DIYPLC/DIY_PLC/src/DIY_PLC_V3.1/TEST HW.jpg

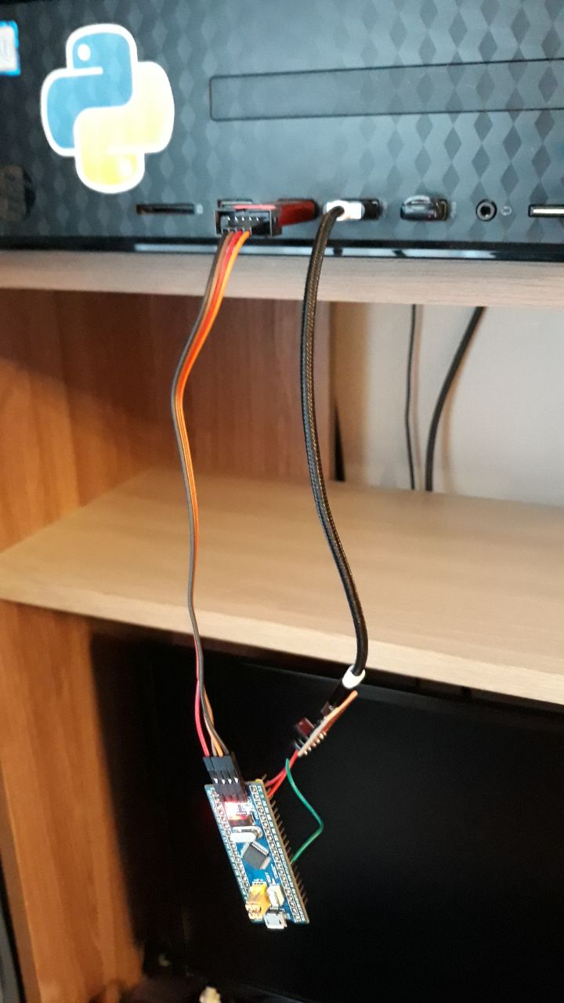
src/DIY_PLC_V3.1/TEST HW.jpg
