DIYPLC/DIY_PLC/Box/photo.jpg

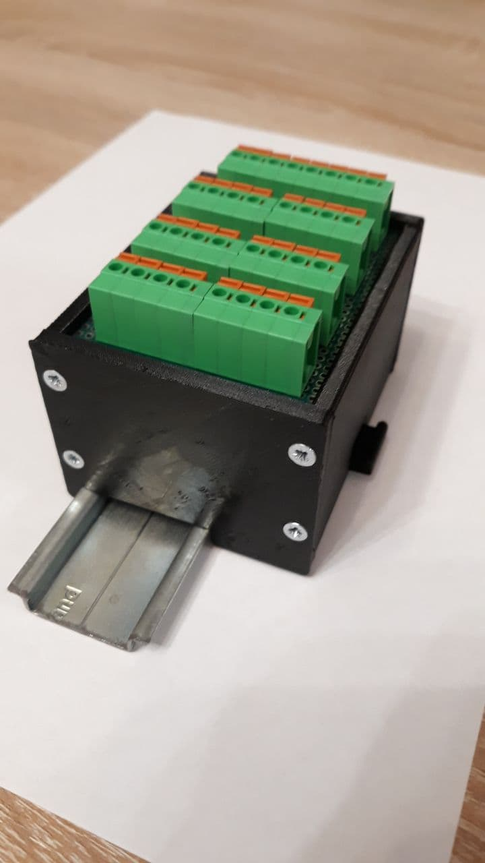
Box/photo.jpg
