DIYPLC/DIY_PLC/PCB/Digital input/PCB_PCB_DI_TLP2362_24V_3V3_2022-10-15.pdf

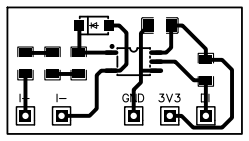
[picture p3: figure]
