DIYPLC/DIY_PLC/PCB/Digital output/PCB_PCB_DO_PVG612SPBF_24V_3V3_2022-10-15.pdf

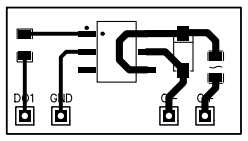
[picture p4: figure]
