DIYPLC/DIY_PLC/PCB/3D.png

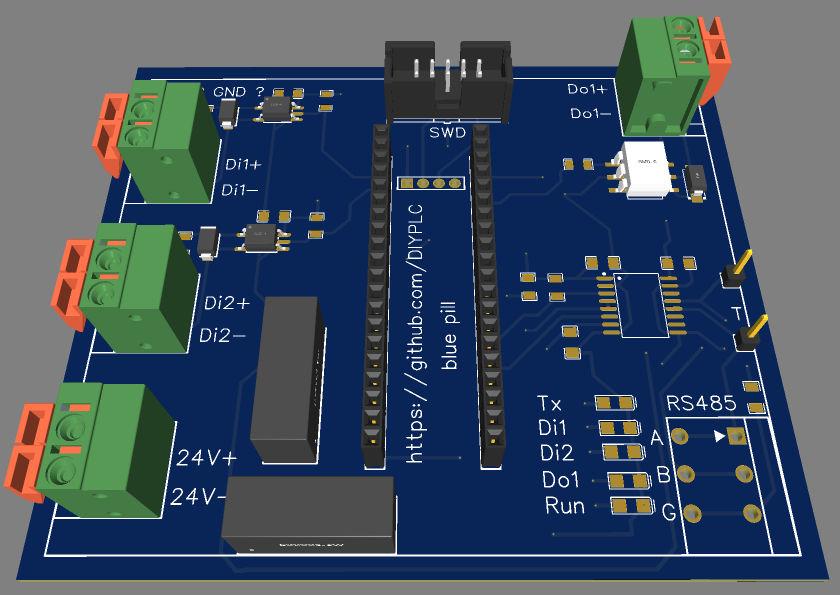
PCB/3D.png
