DIYPLC/DIY_PLC/PCB/BOM_DIY_PLC_V3_2022-04-12.csv

ID | Name | Designator | Footprint | Quantity | Manufacturer Part | Manufacturer | Supplier | Supplier Part | Price | Pins | JLCPCB Part Class | Contributor | JLCPCB Part Class | Resistance (Ohms) | link
1 | 100nF | C1,C2,C3,C5,C7,C8,C9,C10 | C1206 | 8 | GRM31C5C1H104JA01L | MuRata | LCSC | C97946 | 0.138 | 2 | Extended Part
2 | 47uF | C4,C6 | CAP-SMD_L3.5-W2.8-R-RD | 2 | TPSB476K006R0250 | AVX | LCSC | C444791 | 0.387 | 2 | Extended Part | LCSC
3 | 5103308-1 | CN1 | IDC-TH_5103308-1 | 1 | 5103308-1 | TE Connectivity | LCSC | C86466 | 1.323 | 10 | Extended Part
4 | KF142V-5.08-2P | CN2,CN3,CN4,CN5 | CONN-TH_P5.08_KF142V-5.08-2P | 4 | KF142V-5.08-2P | Cixi Kefa Elec | LCSC | C475134 | 0.209 | 2 | Extended Part | LCSC
5 | KF142V-5.08-3P | CN6 | CONN-TH_3P-P5.08_KF142V-5.08-3P | 1 | KF142V-5.08-3P | Cixi Kefa Elec | LCSC | C475135 | 0.268 | 3 | Extended Part | LCSC
6 | US1M_C181135 | D1,D2 | DO-214AC_L4.3-W2.7-LS5.3-FD | 2 | US1M | Hottech | LCSC | C181135 | 0.01 | 2 | Extended Part | 立创EDA官方封装库 | Extended Part
7 | M7 | D3,D4 | SMA_L4.4-W2.8-LS5.4-RD | 2 | M7 | Bourne Semicon (Shenzhen) | LCSC | C266550 | 0.013 | 2 | Extended Part | LCSC
8 | SMBJ28CA-TR | D5 | SMB_L4.6-W3.6-LS5.3-BI | 1 | SMBJ28CA-TR | STMicroelectronics | LCSC | C133664 | 0.13 | 2 | Extended Part | LCSC
9 | 0437.500WR | F1,F2 | F1206 | 2 | 0437.500WR | Littelfuse | LCSC | C206953 | 0.334 | 2 | Extended Part | LCSC
10 | A2541HWV-4P | H1 | HDR-TH_4P-P2.54-V_A2541HWV-4P | 1 | A2541HWV-4P | Changjiang Connectors | LCSC | C225501 | 0.091 | 4 | Extended Part | LCSC
11 | MHT150CYCT | LED1,LED2,LED3,LED4,LED5 | LED1206-RD_YELLOW-1 | 5 | MHT150CYCT | MEIHUA | LCSC | C409783 | 0.06 | 2 | Extended Part | LCSC
12 | Header-Female-2.54_1x20 | P1,P2 | HDR-TH_20P-P2.54-V-F | 2 | 2.54mm 1*20P Female header | BOOMELE | LCSC | C50984 | 0.151 | 20 | Extended Part
13 | 4.7kΩ | R1,R2,R3,R4,R22 | R1206 | 5 | 1206W4F4701T5E | UniOhm | LCSC | C17936 | 0.004 | 2 | Basic Part |  |  | 4.7K
14 | 430Ω | R5,R9 | R1206 | 2 | 1206W4F4300T5E | UniOhm | LCSC | C17965 | 0.004 | 2 | Extended Part |  |  | 430
15 | 1K | R6,R7,R8,R10,R11,R12 | R1206 | 6 | AECR1206F1K00K9 | ResistorToday | LCSC | C328410 | 0.007 | 2 |  | LCSC
16 | 330Ω | R13 | R1206 | 1 | NQ06W4F3300T5E | UNI-ROYAL(Uniroyal Elec) | LCSC | C965041 | 0.009 | 2 | Extended Part | LCSC
17 | 0Ω | R14,R15,R16,R17,R18,R19,R23 | R1206 | 7 | 1206W4F0000T5E | UniOhm | LCSC | C17888 | 0.004 | 2 | Basic Part |  |  | 0
18 | 10kΩ | R20,R21 | R1206 | 2 | 1206W4F1002T5E | UniOhm | LCSC | C17902 | 0.004 | 2 | Basic Part |  |  | 10K
19 | KH-PG2012005-DZ | TP1 | TESTPOINT-TH_KH-PG2012005-DZ | 1 | KH-PG2012005-DZ | kinghelm(金航标) | LCSC | C2842936 | 0.209 | 1 | Extended Part | LCSC
20 | HDR-M-2.54_1x1 | TP2,TP3 | HDR-M-2.54_1X1 | 2 |  |  | LCSC | C81276 | 0.007 | 1 |  | LCEDA_Lib
21 | TLP2362(TPL,E(T | U1,U2 | OPTO-SMD-5_L3.7-W4.6-P1.27-LS7.0-BR | 2 | TLP2362(TPL,E(T | TOSHIBA | LCSC | C37658 | 1.634 | 5 | Extended Part
22 | PVG612SPBF | U1_DO | SMD-6_L8.6-W6.4-P2.54-LS9.4-BL | 1 | PVG612SPBF | Infineon Technologies | LCSC | C538601 | 10.062 | 6 | Extended Part | LCSC
23 | B2405S-2W | U3,U4 | PWRM-TH_BXXXXS-2W | 2 | B2405S-2W | JETEKPS | LCSC | C442554 | 3.625 | 4 | Extended Part | LCSC
24 | AMS1117-3.3S | U5 | SOT-223-4_L6.5-W3.5-P2.30-LS7.0-BL | 1 | AMS1117-3.3S | KEXIN(科信) | LCSC | C2842296 | 0.091 | 4 |  | LCSC |  |  | https://atta.szlcsc.com//upload/public/pdf/source/20220119/687E7B65F4F54F278E2F75AE3BEEDBF9.pdf
25 | ADM2486BRWZ | U6 | SOIC-16_L10.3-W7.5-P1.27-LS10.3-BL | 1 | ADM2486BRWZ | ADI(亚德诺)/LINEAR | LCSC | C658083 | 3.325 | 16 | Extended Part | LCSC
