DIYPLC/DIY_PLC/PCB/Digital input/BOM_DI_TLP2362_24V_3V3_2022-10-15.csv

ID | Name | Designator | Footprint | Quantity | Manufacturer Part | Manufacturer | Supplier | Supplier Part | Price | Pins | JLCPCB Part Class | Contributor | JLCPCB Part Class | Resistance (Ohms)
1 | HDR-M-2.54_1x1 | 3V3,DI,GND,I+,I- | HDR-M-2.54_1X1 | 5 |  |  | LCSC | C81276 | 0.007 | 1 |  | LCEDA_Lib
2 | 100nF | C1 | C1206 | 1 | GRM31C5C1H104JA01L | MuRata | LCSC | C97946 | 0.117 | 2 | Extended Part
3 | US1M_C181135 | D1 | DO-214AC_L4.3-W2.7-LS5.3-FD | 1 | US1M | Hottech | LCSC | C181135 | 0.009 | 2 | Extended Part | 立创EDA官方封装库 | Extended Part
4 | 430Ω | R1 | R1206 | 1 | 1206W4F4300T5E | UniOhm | LCSC | C17965 | 0.003 | 2 | Extended Part |  |  | 430
5 | 1K | R2,R3,R4 | R1206 | 3 | AECR1206F1K00K9 | ResistorToday | LCSC | C328410 | 0.012 | 2 |  | LCSC
6 | TLP2362(TPL,E(T | U1 | OPTO-SMD-5_L3.7-W4.6-P1.27-LS7.0-BR | 1 | TLP2362(TPL,E(T | TOSHIBA | LCSC | C37658 | 0.661 | 5 | Extended Part
