DIYPLC/DIY_PLC/PCB/Digital output/BOM_DO_PVG612SPBF_24V_3V3_2022-10-15.csv

ID | Name | Designator | Footprint | Quantity | Manufacturer Part | Manufacturer | Supplier | Supplier Part | Price | Pins | JLCPCB Part Class | Contributor
1 | M7 | D3 | SMA_L4.4-W2.8-LS5.4-RD | 1 | M7 | Bourne Semicon (Shenzhen) | LCSC | C266550 | 0.012 | 2 | Extended Part | LCSC
2 | HDR-M-2.54_1x1 | DO1,GND,O+,O- | HDR-M-2.54_1X1 | 4 |  |  | LCSC | C81276 | 0.007 | 1 |  | LCEDA_Lib
3 | 0437.500WR | F1 | F1206 | 1 | 0437.500WR | Littelfuse | LCSC | C206953 | 0.296 | 2 | Extended Part | LCSC
4 | 330Ω | R13 | R1206 | 1 | NQ06W4F3300T5E | UNI-ROYAL(Uniroyal Elec) | LCSC | C965041 | 0.011 | 2 | Extended Part | LCSC
5 | PVG612SPBF | U1_DO | SMD-6_L8.6-W6.4-P2.54-LS9.4-BL | 1 | PVG612SPBF | Infineon Technologies | LCSC | C538601 | 3.641 | 6 | Extended Part | LCSC
