DIYPLC/DIY_PLC/Box/Корпус DIN v7 PCB120x80.stl

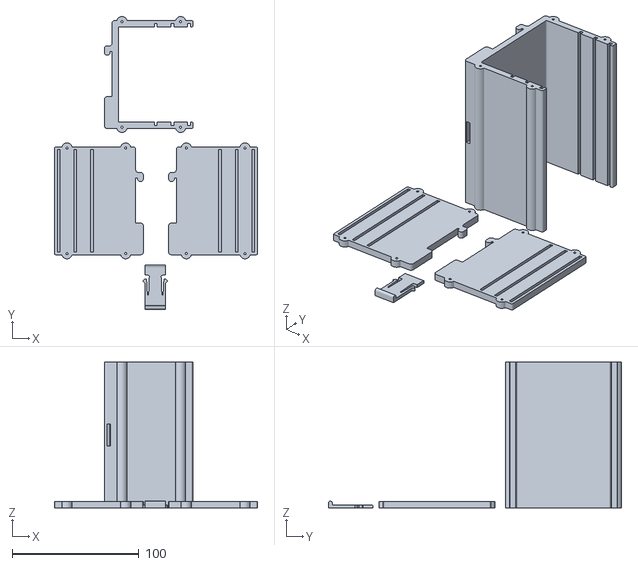
[picture p6: CAD file, 2022-10-21]
Box/Корпус DIN v7 PCB120x80.stl
160.0 x 230.9 x 115.0
