DIYPLC/DIY_PLC/PCB/Digital input/PCB_DI_TLP2362_24V_3V3_2022-10-15.dxf

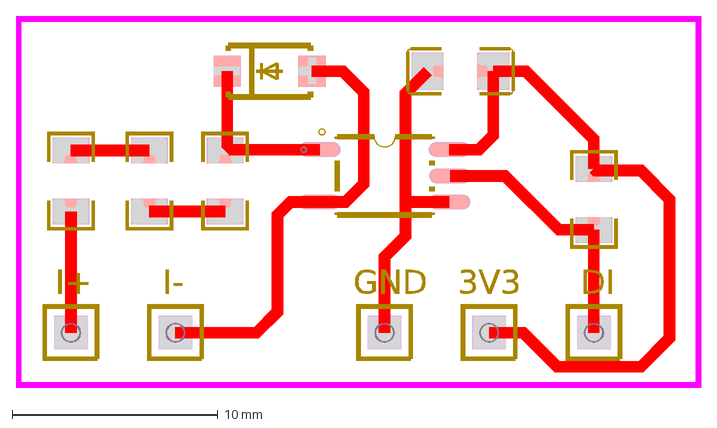
[picture p7: CAD file, 2022-10-15]
PCB/Digital input/PCB_DI_TLP2362_24V_3V3_2022-10-15.dxf
3V3
GND
DI
I+
I-
