DIYPLC/DIY_PLC/PCB/Digital output/PCB_DO_PVG612SPBF_24V_3V3_2022-10-15.dxf

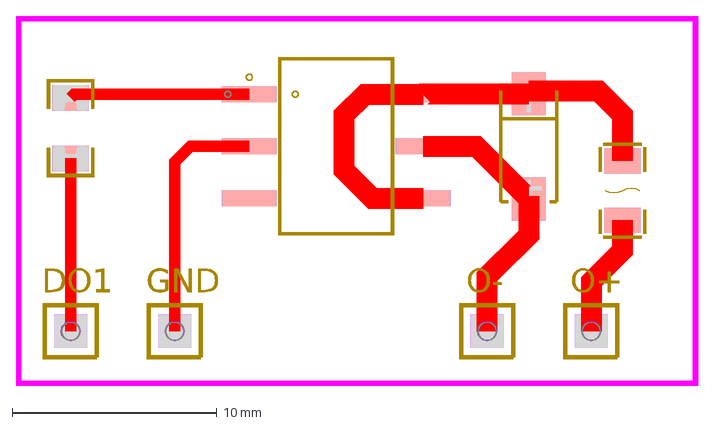
[picture p8: CAD file, 2022-10-15]
PCB/Digital output/PCB_DO_PVG612SPBF_24V_3V3_2022-10-15.dxf
DO1
GND
O+
O-
