DIYPLC/DIY_PLC/PCB/RS485/PCB_RS485_ADM2486BRWZ_2022-10-15.dxf

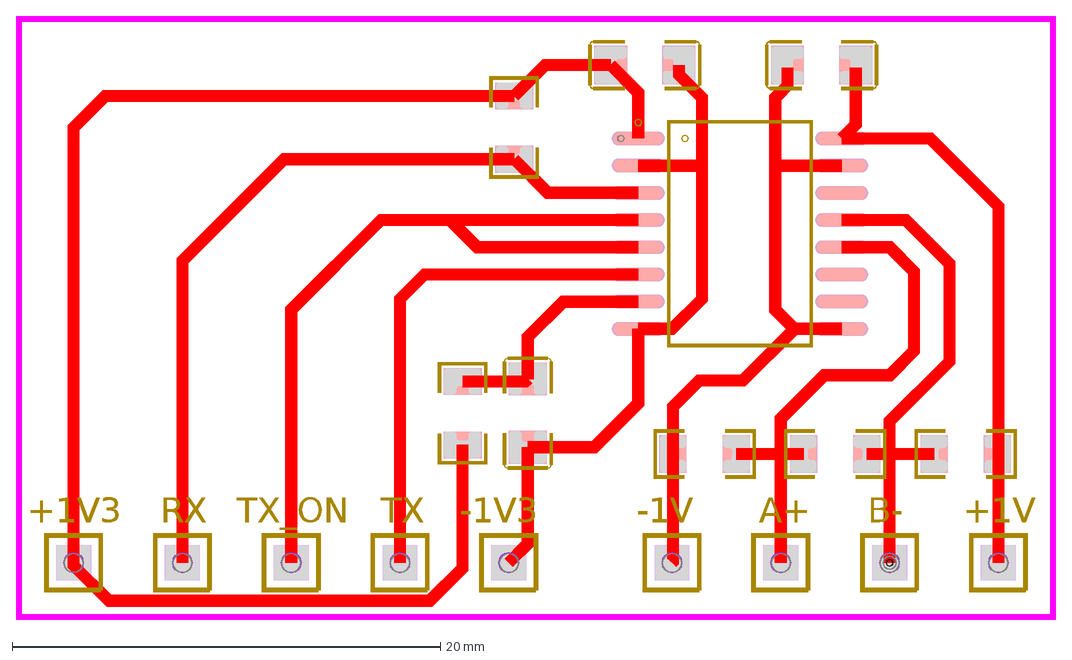
[picture p9: CAD file, 2022-10-15]
PCB/RS485/PCB_RS485_ADM2486BRWZ_2022-10-15.dxf
A+
B-
RX
TX
TX_ON
+1V
+1V3
-1V
-1V3
