DIYPLC/DIY_PLC/Box/Архив/Корпус DIN v6 PCB 100x85.FCStd

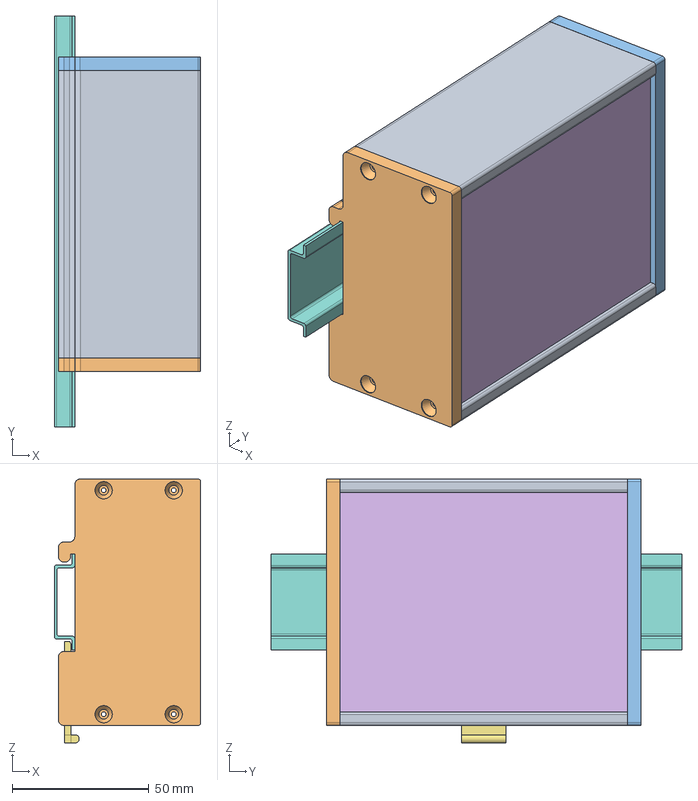
[picture p10: CAD file, 2022-10-21]
Box/Архив/Корпус DIN v6 PCB 100x85.FCStd
53.5 x 150.0 x 96.4 mm
корпус
крышка Левая
крышка правая
плата 1
плата2
плата 3
защёлка
DIN-рейка
