DIYPLC/DIY_PLC/(list of files, cad)

Other CAD files:
Box/Архив/Корпус DIN v5 PCB 80x60.dxf
Box/Архив/Корпус DIN v6 PCB 100x85.dxf
Box/Корпус DIN v7 PCB120x80.dxf
