DIYPLC/DIY_PLC/PCB/Schematic_DIY_PLC_V3_2022-04-12.pdf

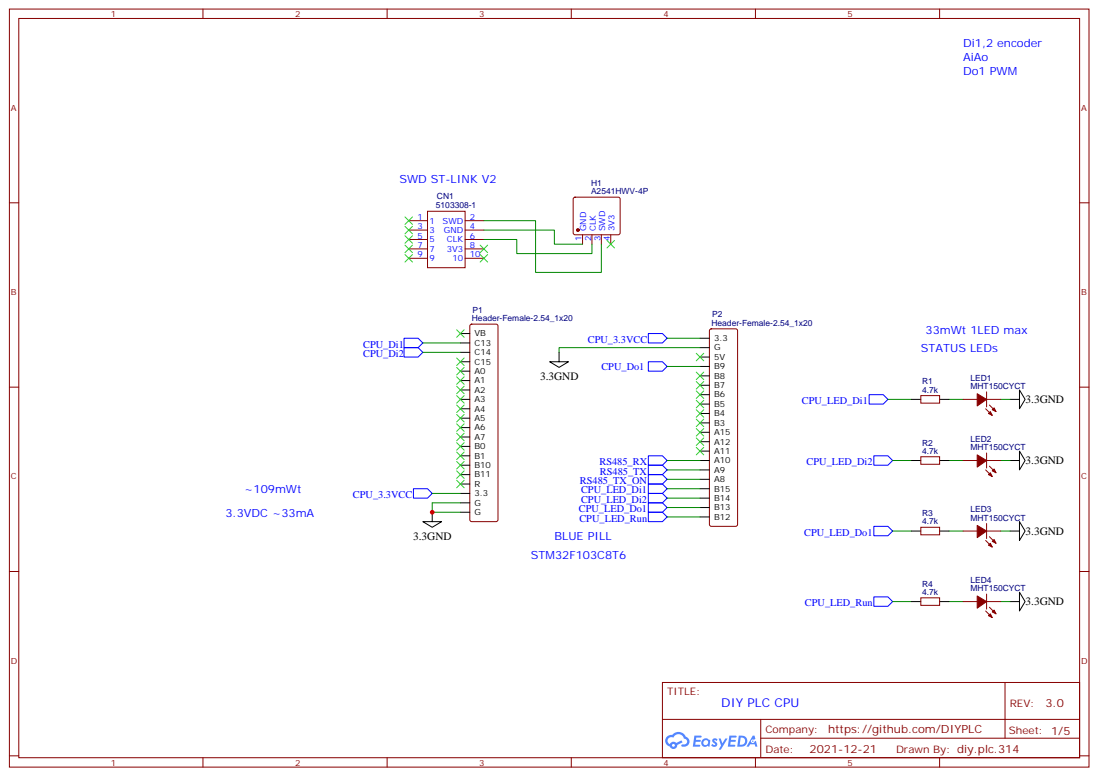
[picture p11: page 1]

Company: https://github.com/DIYPLC

Drawn By: diy.plc.314

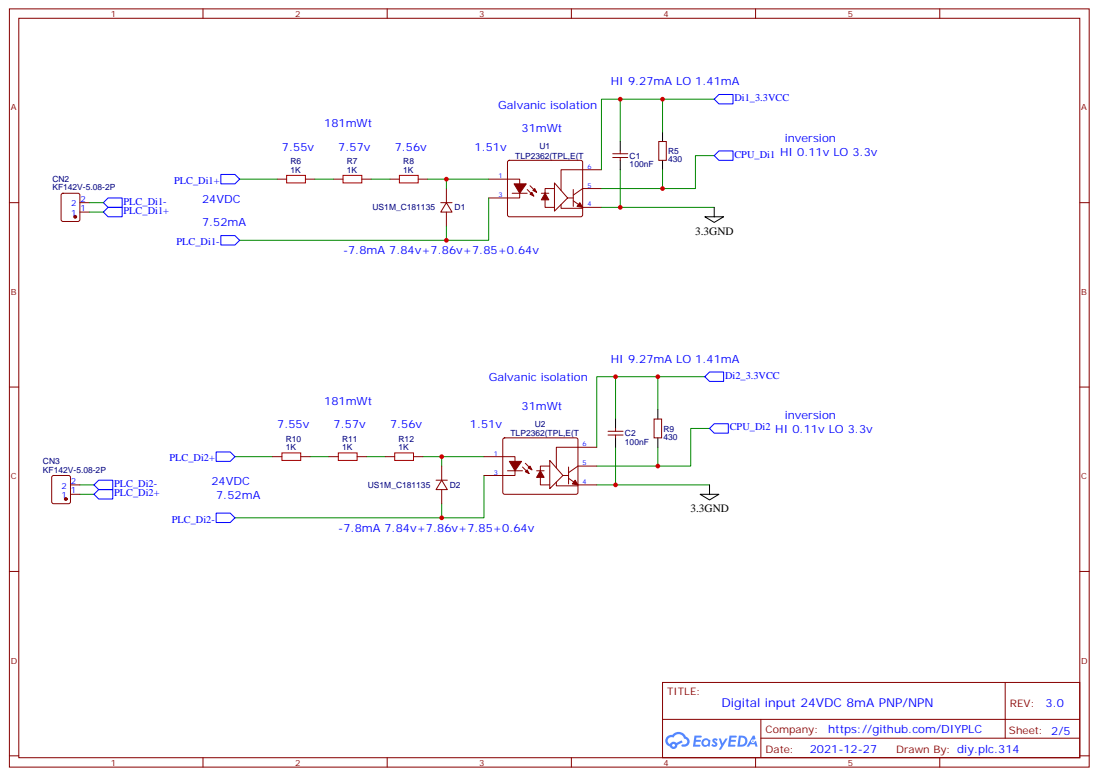
[picture p12: page 2]

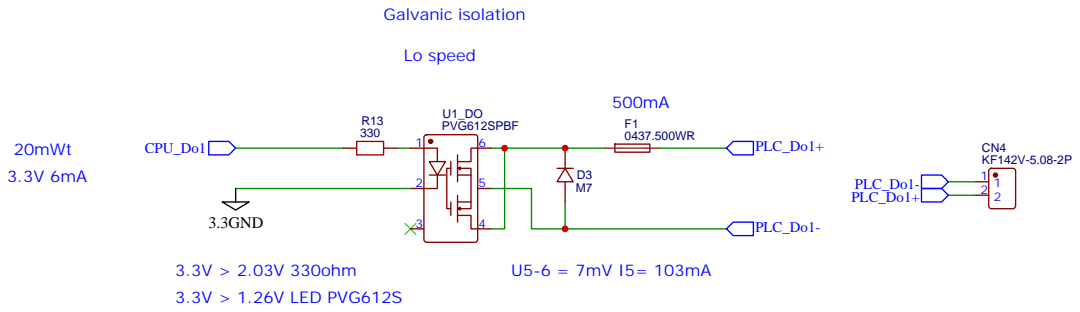
[picture p13: page 3]

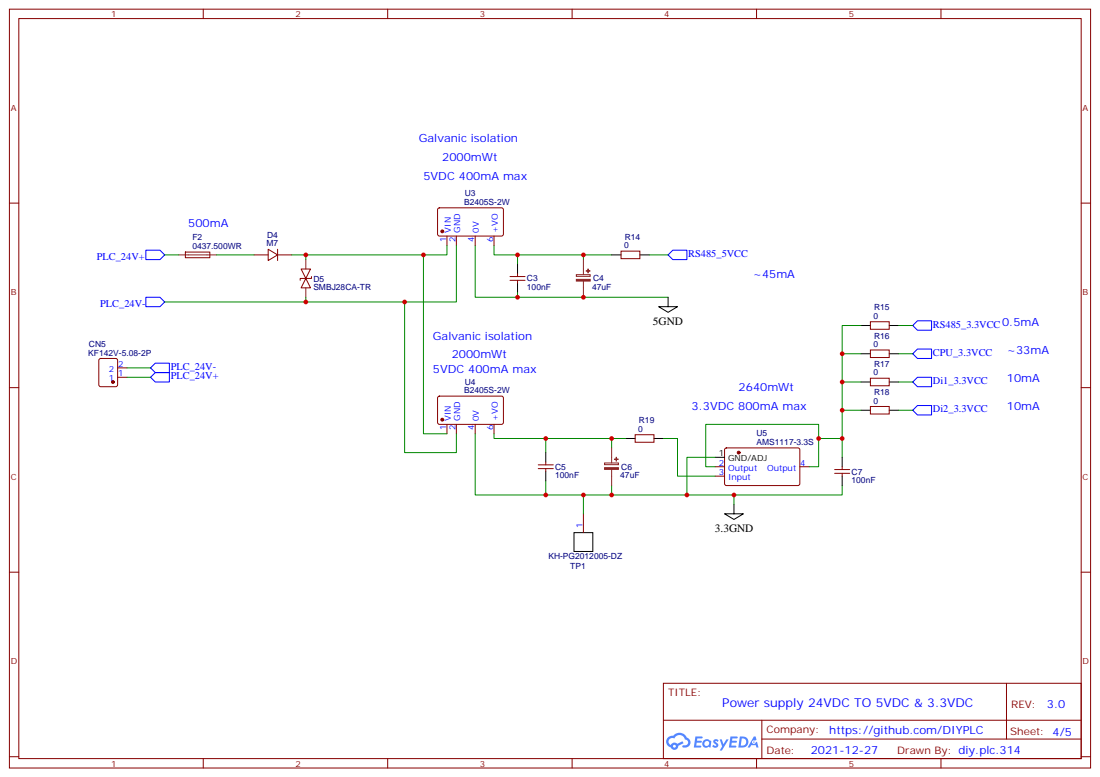
[picture p14: page 4]

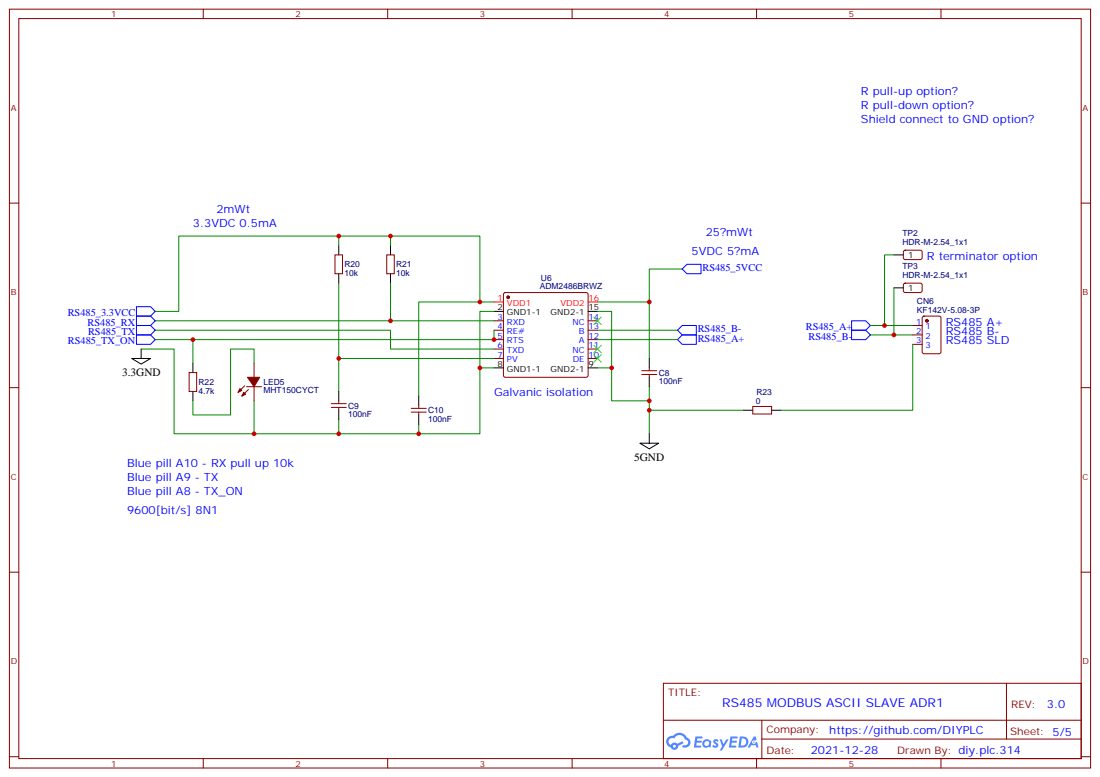
[picture p15: page 5]

R pull-up option?
R pull-down option?
Shield connect to GND option?

Blue pill A10 - RX pull up 10k
Blue pill A9 - TX
Blue pill A8 - TX_ON
9600[bit/s] 8N1
