DIYPLC/DIY_PLC/Box/Защелка v7 PCB120x80-А4.pdf

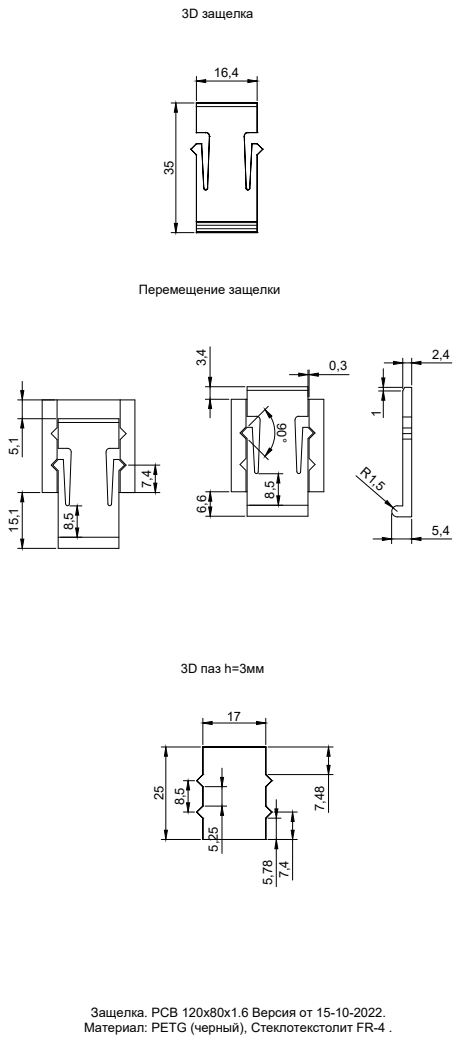
[picture p16: page 1]
3D защелка 3,4 6,6; Перемещение защелки; 3D паз h=3мм

Защелка. PCB 120x80x1.6 Версия от 15-10-2022.
Материал: PETG (черный), Стеклотекстолит FR-4 .
