DIYPLC/DIY_PLC/Box/Корпус DIN v7 PCB120x80-А4.pdf

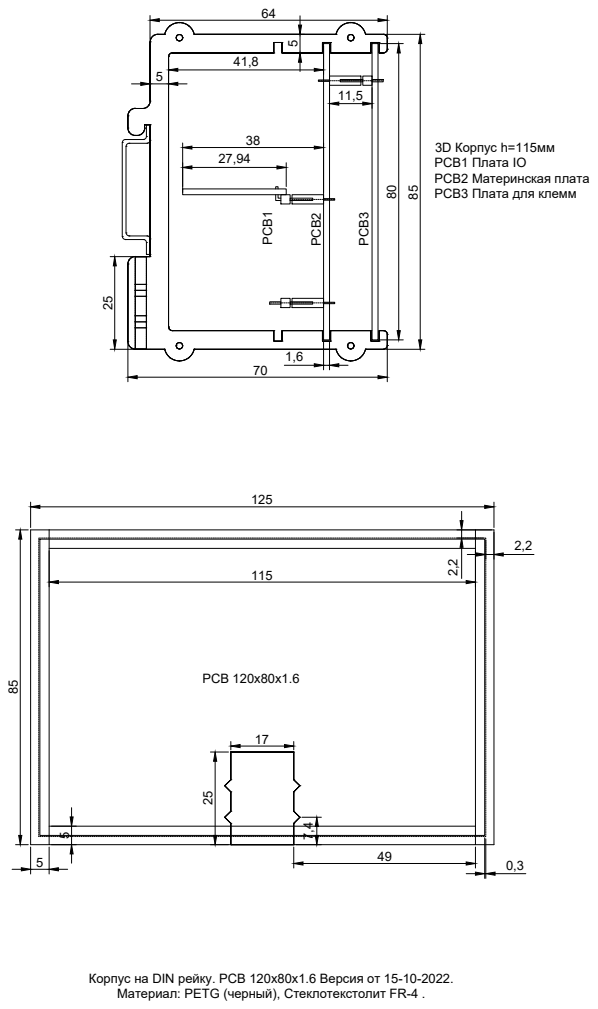
[picture p17: page 1]
11,5 PCB1; PCB2; PCB3; PCB 120x80x1.6

3D Корпус h=115мм
PCB1 Плата IO
PCB2 Материнская плата
PCB3 Плата для клемм

Корпус на DIN рейку. PCB 120x80x1.6 Версия от 15-10-2022.
Материал: PETG (черный), Стеклотекстолит FR-4 .
