DIYPLC/DIY_PLC/Box/Крышки v7 PCB120x80-А4.pdf

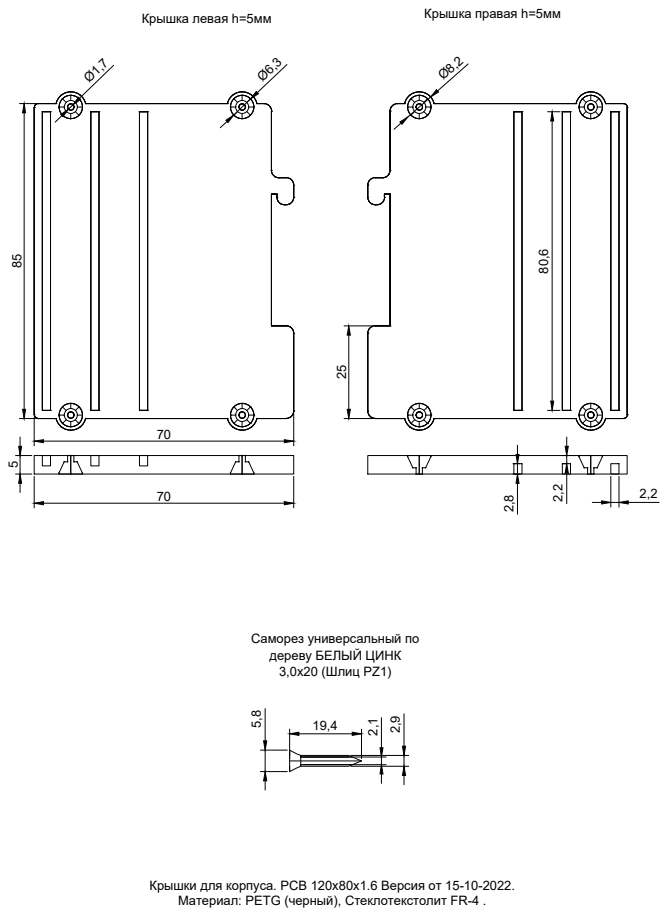
[picture p18: page 1]
Крышка левая h=5мм; Крышка правая h=5мм

Саморез универсальный по
дереву БЕЛЫЙ ЦИНК
3,0х20 (Шлиц PZ1)

Материал: PETG (черный), Стеклотекстолит FR-4 . 5,8

Крышки для корпуса. PCB 120x80x1.6 Версия от 15-10-2022.
