DIYPLC/DIY_PLC/PCB/Digital input/Schematic_DI_TLP2362_24V_3V3_2022-10-15.pdf

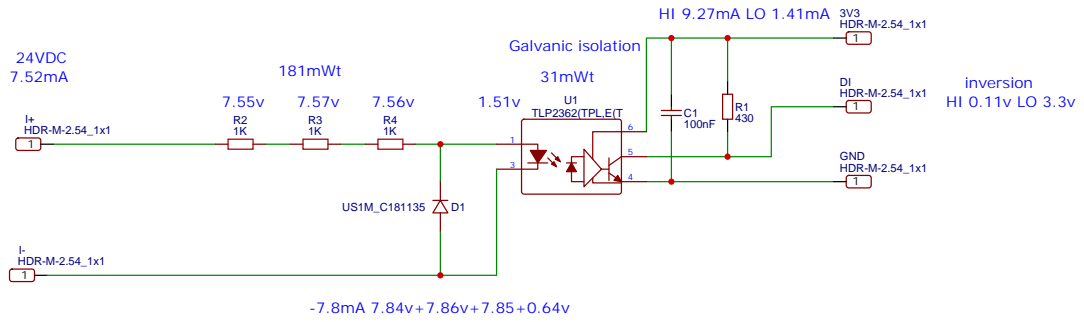
[picture p19: page 1]

Company: https://github.com/DIYPLC

Drawn By: diy.plc.314
