DIYPLC/DIY_PLC/PCB/Digital output/Schematic_DO_PVG612SPBF_24V_3V3_2022-10-15.pdf

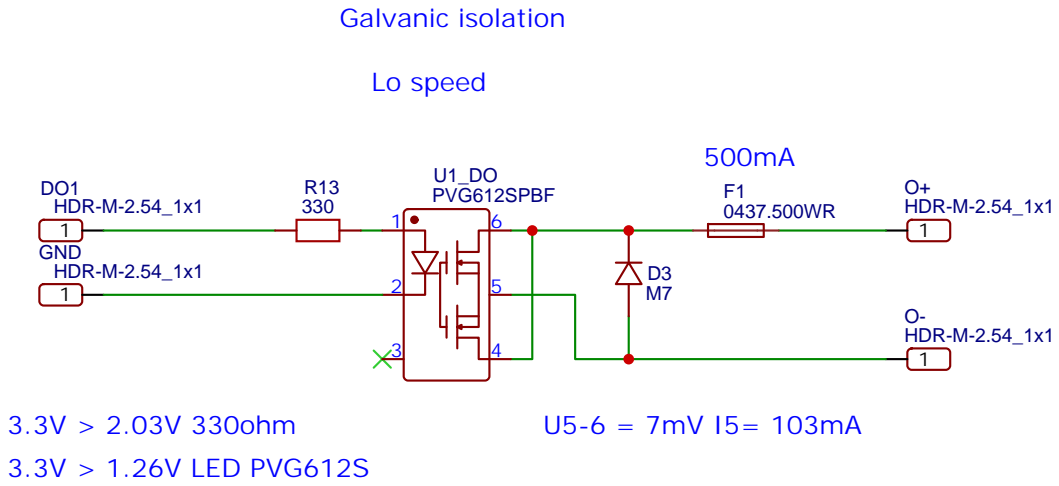
[picture p20: page 1]

Company: https://github.com/DIYPLC

Drawn By: diy.plc.314
