DIYPLC/DIY_PLC/PCB/RS485/Schematic_RS485_ADM2486BRWZ_2022-10-15.pdf

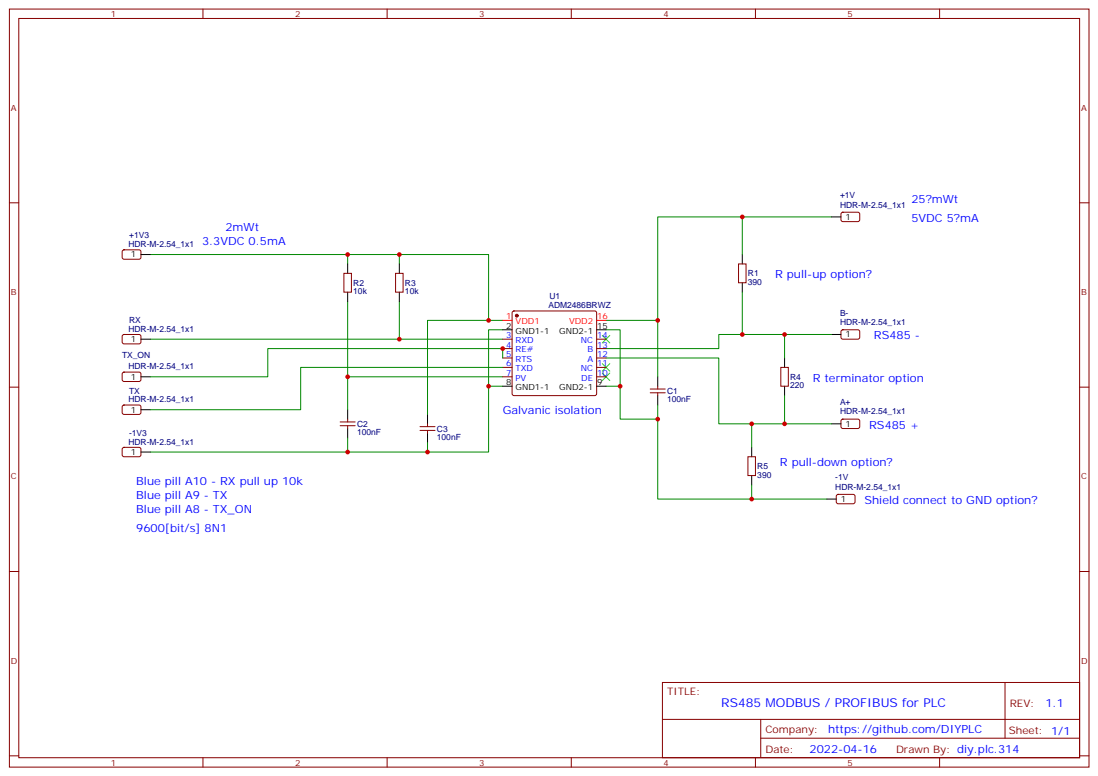
[picture p21: page 1]
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

Company: https://github.com/DIYPLC

Drawn By: diy.plc.314
