DIYPLC/DIY_PLC/PCB/PCB_PCB_DIY_PLC_V3_2022-04-12.pdf

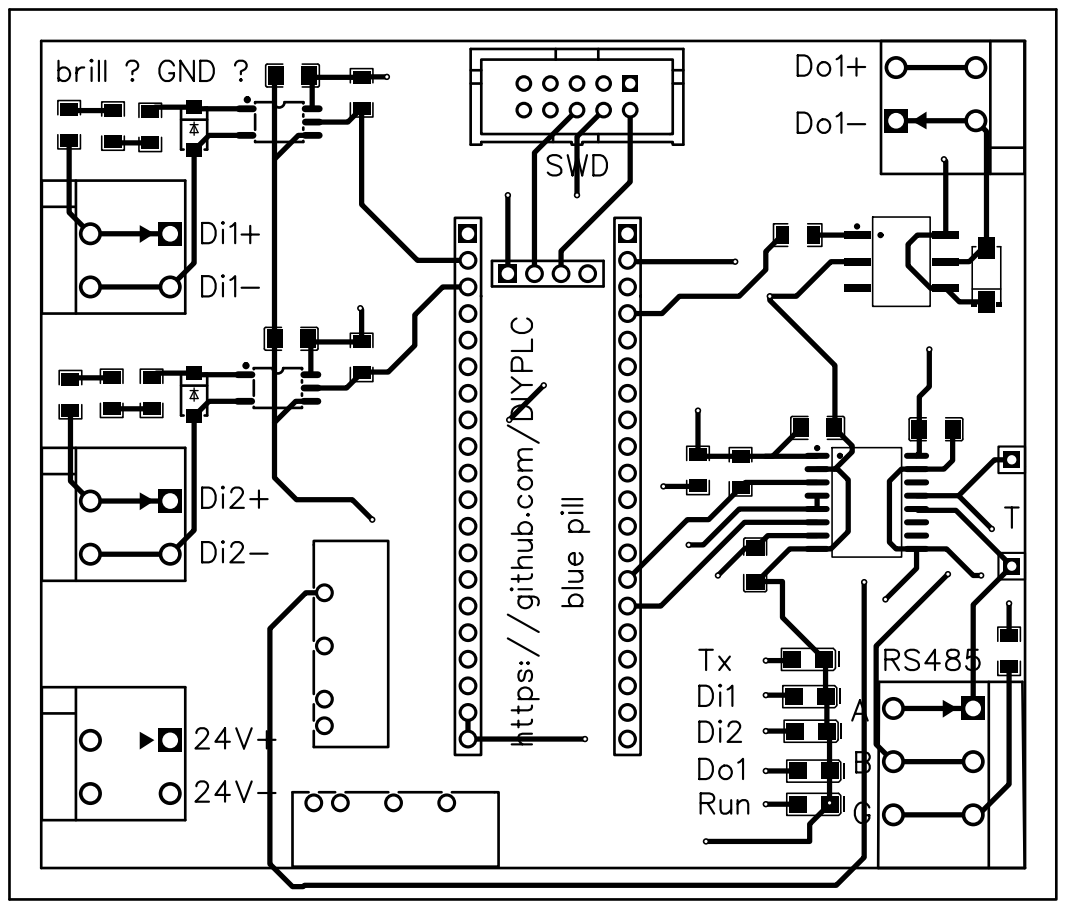
[picture p22: page 1]
