DIYPLC/DIY_PLC/PCB/RS485/PCB_PCB_RS485_ADM2486BRWZ_2022-10-15.pdf

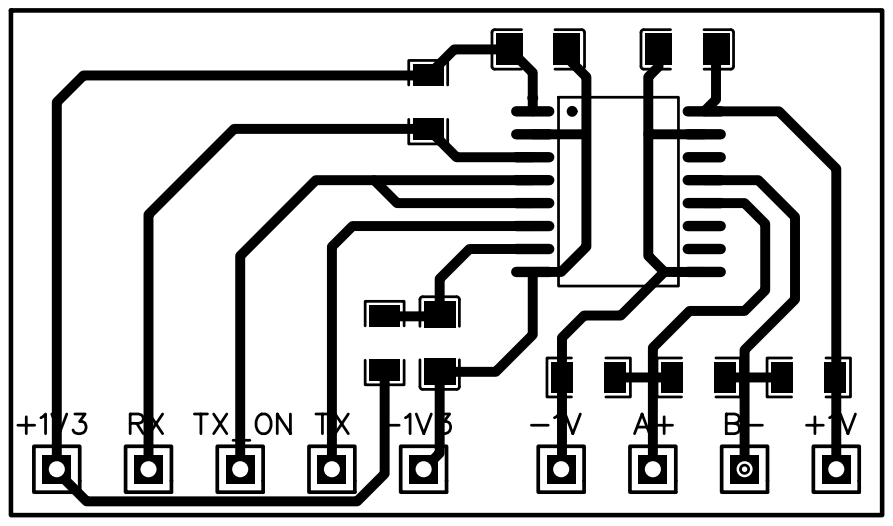
[picture p23: page 1]
