DIYPLC/DIY_PLC/src/DIY_PLC_V3.1/main.c

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
/* Includes ------------------------------------------------------------------*/
#include "main.h"

/* USER CODE BEGIN Includes */
#include <stdint.h>
#include <stdbool.h>
#include <iso646.h>

#include "mb.h" //MODBUS RTU SLAVE
#include "GlobalVar.h"
#include "FbTs.h"
#include "FbBlink.h"
#include "FbFilterA.h"
/* USER CODE END Includes */

/* USER CODE BEGIN PD */
#define SetBit(Var,Bit)   ( Var = Var |  (1 << (Bit)) )
#define ResetBit(Var,Bit) ( Var = Var & ~(1 << (Bit)) )

#define USER_LED_ON() HAL_GPIO_WritePin(GPIOC, GPIO_PIN_13, GPIO_PIN_RESET)
#define USER_LED_OFF() HAL_GPIO_WritePin(GPIOC, GPIO_PIN_13, GPIO_PIN_SET)
//#define USER_BUTTON_STATE() (HAL_GPIO_ReadPin(GPIOA, GPIO_PIN_0) != GPIO_PIN_SET)

#define millis() HAL_GetTick() //Arduino function.
#define Reboot_CPU() HAL_NVIC_SystemReset()

#define MODBUS_RTU_SLAVE_ADDRESS 1
#define MW usSRegHoldBuf //MODBUS HOLDING REGISTERS
/* USER CODE END PD */

TIM_HandleTypeDef htim3;

UART_HandleTypeDef huart2;

/* USER CODE BEGIN PV */
static struct GlobalVar GV = { 0 };
static struct DbTs DbTs1 = { 0 };
extern USHORT usSRegHoldBuf[]; //MODBUS RTU SLAVE HOLDING REGISTERS
static struct DbBlink DbBlink1 = { 0 };
static struct DbFilterA DbFilterA1 = { 0 };
/* USER CODE END PV */

void SystemClock_Config(void);
static void MX_GPIO_Init(void);
static void MX_TIM3_Init(void);
static void MX_USART2_UART_Init(void);
/* USER CODE BEGIN 0 */
void setup(void);
void loop(void);
void FcTaskCyclic(bool Reset, uint32_t Ts_ms);
/* USER CODE END 0 */

/**
 * @brief  The application entry point.
 * @retval int
 */
int main(void) {
	/* MCU Configuration--------------------------------------------------------*/

	/* Reset of all peripherals, Initializes the Flash interface and the Systick. */
	HAL_Init();

	/* Configure the system clock */
	SystemClock_Config();

	/* Initialize all configured peripherals */
	MX_GPIO_Init();
	MX_TIM3_Init();
	MX_USART2_UART_Init();
	/* Infinite loop */
	/* USER CODE BEGIN WHILE */
	setup();
	while (1) {
		loop();
		/* USER CODE END WHILE */

		/* USER CODE BEGIN 3 */
	}
	/* USER CODE END 3 */
}

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
/* USER CODE BEGIN 4 */
void setup(void) //Arduino function.
{

	eMBInit(MB_RTU, MODBUS_RTU_SLAVE_ADDRESS, &huart2,
			(ULONG) huart2.Init.BaudRate, &htim3); //MODBUS RTU SLAVE
	eMBEnable(); //MODBUS RTU SLAVE

	GV.Reset = true;
	//Расчет времени скана.
	//             DbTs
	//    +---------------------+
	//    |        FbTs         |
	//   -|millis          Ts_ms|->-
	//   -|Reset              Ts|->-
	//    |            Ts_ms_max|->-
	//    |             Uptime_s|->-
	//    +---------------------+
	DbTs1.millis = millis(); //millis() Arduino.
	DbTs1.Reset = GV.Reset; //Сброс при перезагрузке.
	FbTs(&DbTs1); //Расчет времени скана.
	GV.Ts_ms = DbTs1.Ts_ms; //Шаг дискретизации по времени [мс].
	GV.Ts = DbTs1.Ts; //Шаг дискретизации по времени [с].
	GV.Ts_ms_max = DbTs1.Ts_ms_max; //Максимальное время скана [мс].
	GV.Uptime_s = DbTs1.Uptime_s; //Время в работе [мс].

	FcTaskCyclic(GV.Reset, GV.Ts_ms); //PLC Task 1
	return;
}

void loop(void) //Arduino function.
{

	eMBErrorCode retu;
	retu = eMBPoll(); //MODBUS RTU SLAVE
	if (retu == MB_ENOERR) {
		;
	} // IF OK

	GV.Reset = false;
	//Расчет времени скана.
	//             DbTs
	//    +---------------------+
	//    |        FbTs         |
	//   -|millis          Ts_ms|->-
	//   -|Reset              Ts|->-
	//    |            Ts_ms_max|->-
	//    |             Uptime_s|->-
	//    +---------------------+
	DbTs1.millis = millis();	//millis() Arduino.
	DbTs1.Reset = GV.Reset;	//Сброс при перезагрузке.
	FbTs(&DbTs1);	//Расчет времени скана.
	GV.Ts_ms = DbTs1.Ts_ms;	//Шаг дискретизации по времени [мс].
	GV.Ts = DbTs1.Ts;	//Шаг дискретизации по времени [с].
	GV.Ts_ms_max = DbTs1.Ts_ms_max;	//Максимальное время скана [мс].
	GV.Uptime_s = DbTs1.Uptime_s;	//Время в работе [мс].

	//PLC Cyclic Task1
	FcTaskCyclic(GV.Reset, GV.Ts_ms);	//PLC Task 1

	//PLC digital output
	if (GV.Do1) {
		USER_LED_ON();
	} else {
		USER_LED_OFF();
	}

	return;
}

void FcTaskCyclic(bool Reset, uint32_t Ts_ms) //PLC ST style logic.
{

	//Время работы мс.
	MW[0] = 0x7fff bitand millis(); //0x7fff ограничение до 2**15-1

	//Время скана мс.
	MW[1] = 0x7fff bitand GV.Ts_ms; //0x7fff ограничение до 2**15-1

	//Максимальное время скана мс.
	MW[2] = 0x7fff bitand GV.Ts_ms_max; //0x7fff ограничение до 2**15-1

	//Blink
	MW[3] = GV.Do1;

	//Тест на сложение.
	if (Reset) {
		MW[4] = -2;
		MW[5] = 6;
	}
	MW[6] = MW[4] + MW[5];

	//Пример работы с дискретными алгоритмами.
	//Мигалка.
	//            DbBlink
	//    +---------------------+
	//    |       FbBlink       |
	//   -|Time_on_ms        Out|->-
	//   -|Time_off_ms          |
	//   -|Ts_ms                |
	//   -|Reset                |
	//    +---------------------+
	DbBlink1.Time_on_ms = 500;	//Время импульса [мс].
	DbBlink1.Time_off_ms = 500;	//Время паузы [мс].
	DbBlink1.Ts_ms = Ts_ms;	//Шаг дискретизации по времени [мс].
	DbBlink1.Reset = Reset;	//Сброс при перезагрузке.
	FbBlink(&DbBlink1);	//Мигалка.
	GV.Do1 = DbBlink1.Out;	//Мигающая лампочка.

	//Пример работы с аналоговыми алгоритмами.
	//Фильтр апериодический.
	//      DbFilterA
	//    +-----------+
	//    | FbFilterA |
	// ->-|In      Out|->-
	//   -|Tf         |
	//   -|Ts         |
	//    +-----------+
	DbFilterA1.In = (float) DbBlink1.Out;	//Входной сигнал до фильтрации.
	DbFilterA1.Tf = 0.15;	//Постоянная времени фильтра [с].
	DbFilterA1.Ts = GV.Ts;	//Шаг дискретизации по времени [с].
	FbFilterA(&DbFilterA1);	//Фильтр апериодический.
	//            = DbFilterA1.Out; //Выходной сигнал после фильтрации.

	return;
}
/* USER CODE END 4 */
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
