DIYPLC/DIY_PLC/(commit log)

2022-08-23 Add files via upload
    Опечатка
2022-08-25 Add files via upload
    коменты
2022-09-03 Add files via upload
    MODBUS рефакторинг и упрощение.
2022-09-04 Add files via upload
    рефакторинг
2022-09-04 Add files via upload
    поиск решения проблем с сетью
2023-09-23 Add files via upload
    Синхронизация с STM32
2023-09-23 Add files via upload
    STM32 MODBUS RTU !!!
2023-09-23 Add files via upload
    Библиотеки
2023-12-04 Добавил дискретный ввод вывод
2024-01-30 Дельный совет от коллег.
2024-02-19 синхронизация
2024-08-19 интеграция
2024-10-13 синхронизация.
